profdc9/Emu2350/EmuBoard2350/EmuBoard2350.pdf

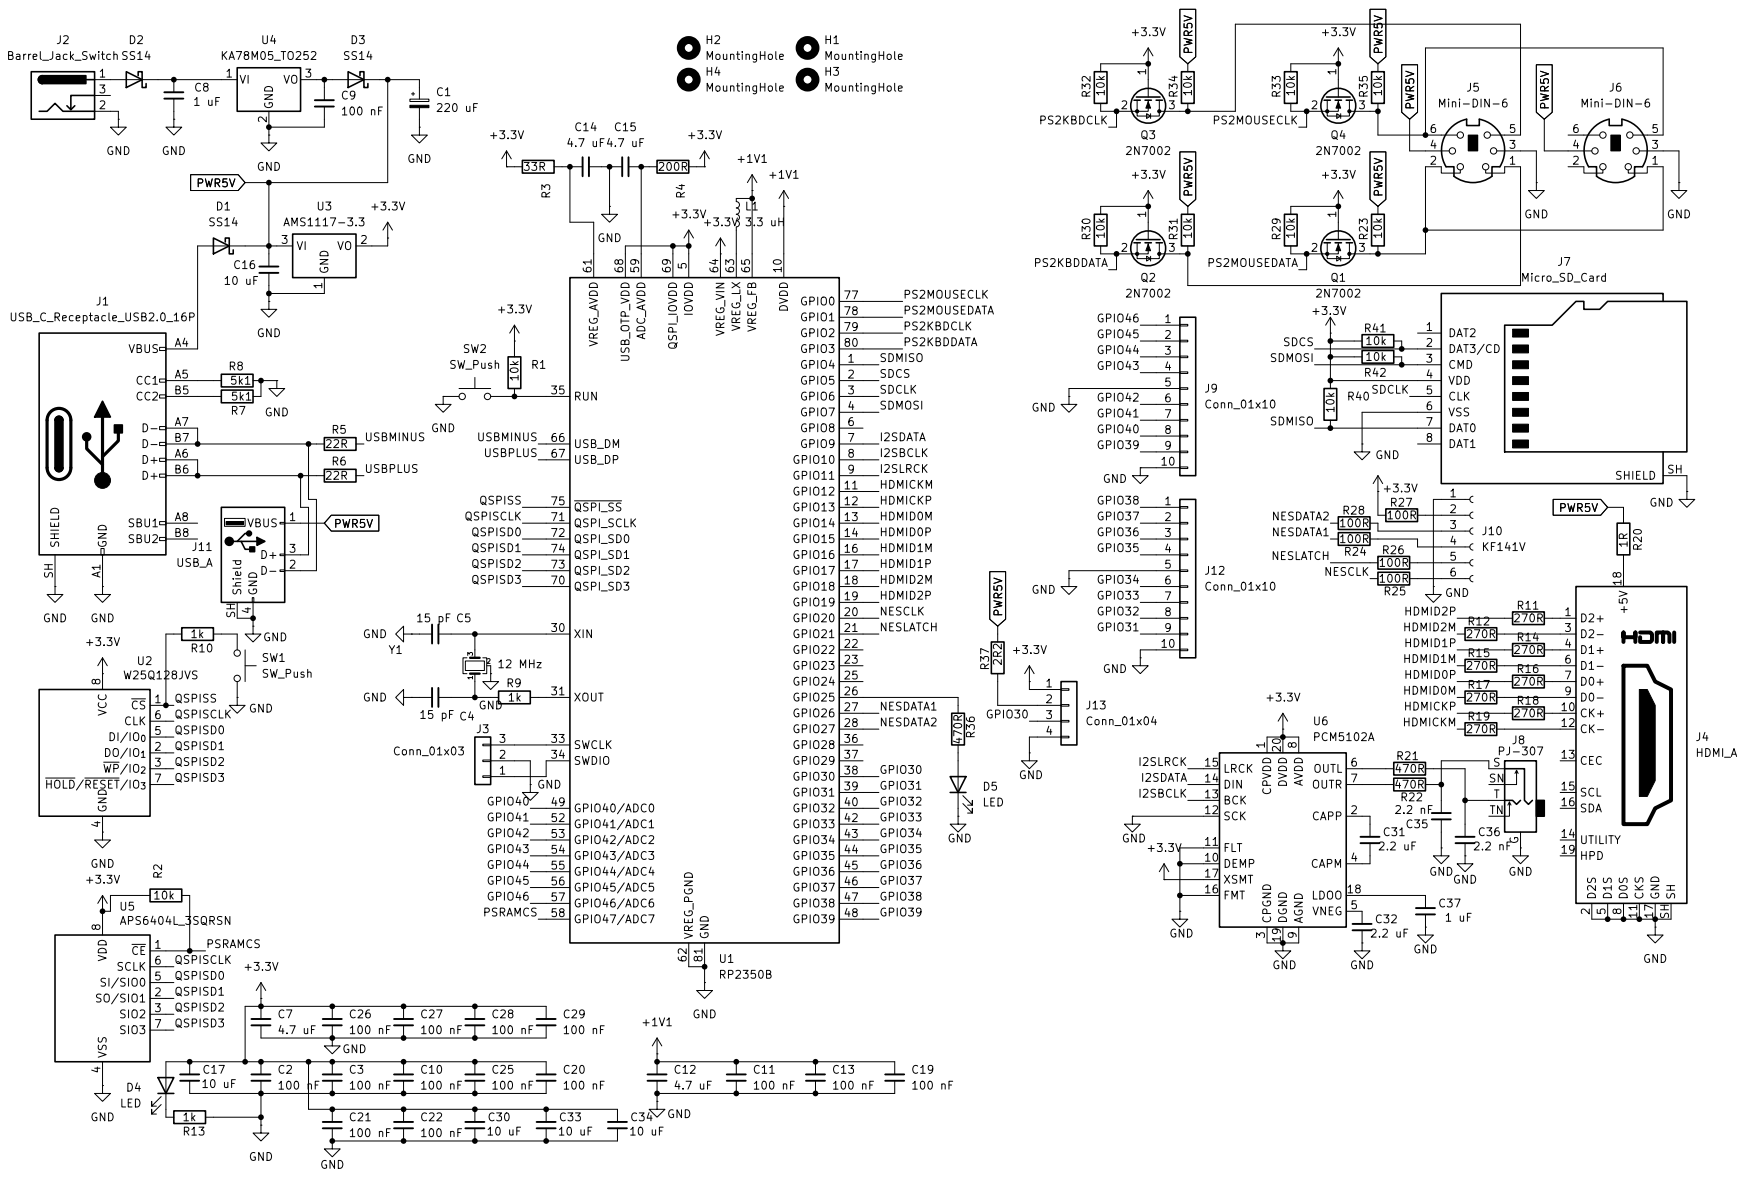
[picture p2: page 1]
