profdc9/Emu2350/EmuBoard2350/EmuBoard2350.kicad_pcb

## KiCad design EmuBoard2350/EmuBoard2350.kicad_pcb (2026-10-18)

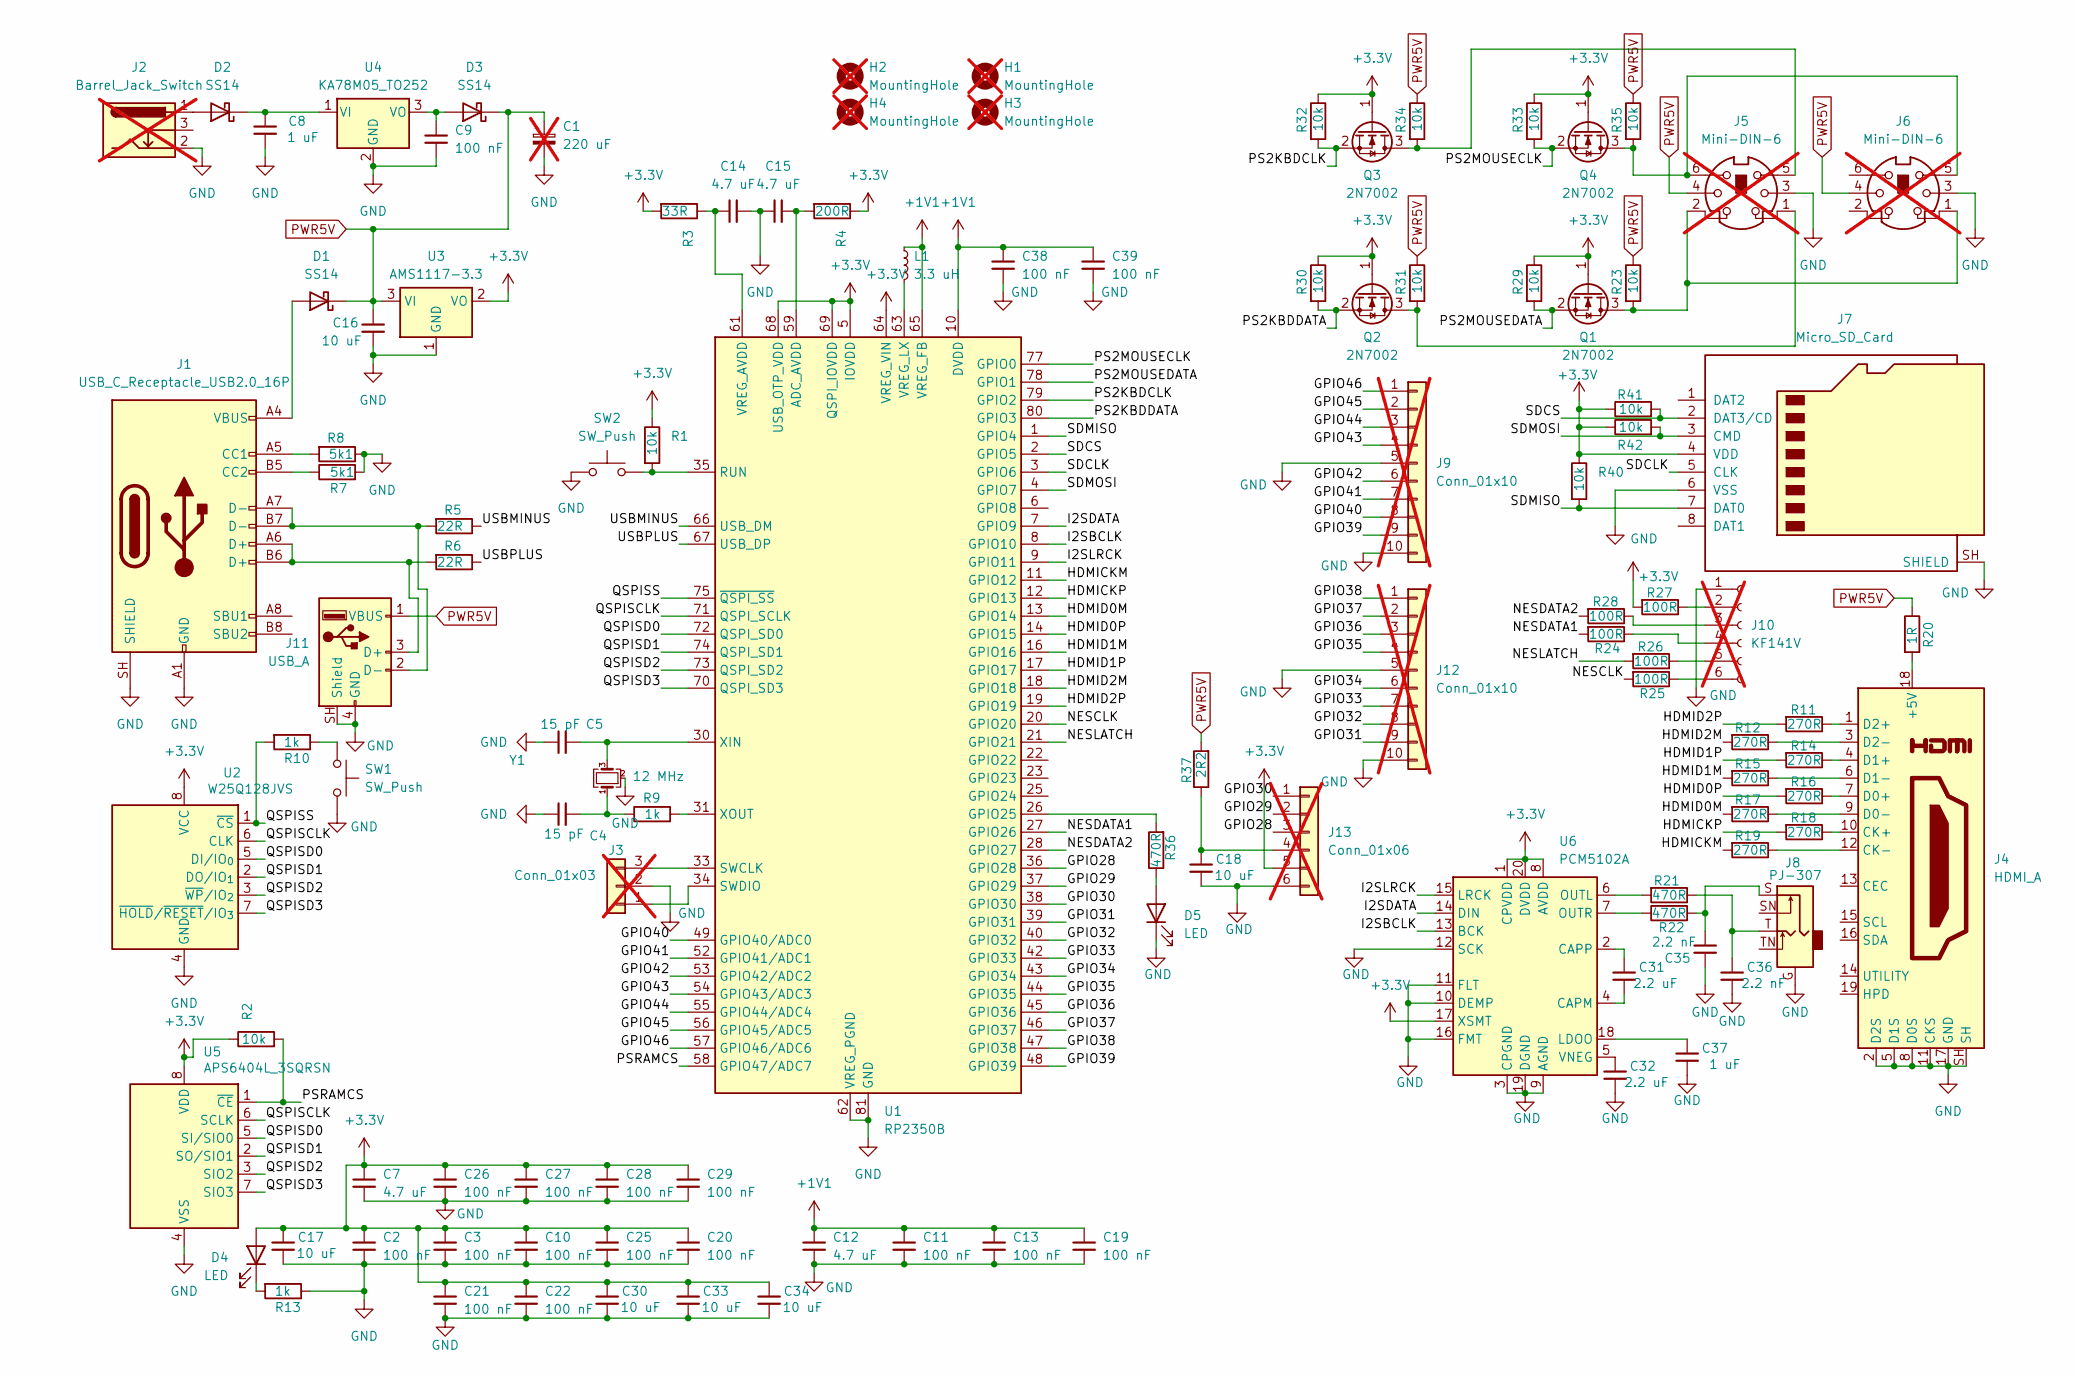
[picture p3: schematic EmuBoard2350.kicad_sch]

Parts:
C1: 220 uF; CP_Radial_D5.0mm_P2.00mm; LCSC DNP; not fitted
C2, C3, C9, C10, C11, C13, C19, C20, C21, C22, C25, C26, C27, C28, C29, C38, C39: 100 nF; C_0402_1005Metric; LCSC C1525
C4, C5: 15 pF; C_0402_1005Metric; LCSC C1548
C7, C12, C14, C15: 4.7 uF; C_0603_1608Metric; LCSC C19666
C8, C37: 1 uF; C_0603_1608Metric; LCSC C15849
C16, C17, C18, C30, C33, C34: 10 uF; C_0603_1608Metric; LCSC C19702
C31, C32: 2.2 uF; C_0603_1608Metric; LCSC C23630
C35, C36: 2.2 nF; C_0603_1608Metric; LCSC C1604
D1, D2, D3: SS14; D_SMA; LCSC C2480
D4: LED; LED_0805_2012Metric; LCSC C2297
D5: LED; LED_0805_2012Metric; LCSC C2296
H1, H2, H3, H4: MountingHole; MountingHole_3.2mm_M3; not fitted
J1: USB_C_Receptacle_USB2.0_16P; TYPE-C-31-M-12; LCSC C165948
J2: Barrel_Jack_Switch; BarrelJack_Horizontal; not fitted
J3: Conn_01x03; PinHeader_1x03_P2.54mm_Vertical; not fitted
J4: HDMI_A; HDMI_A_Molex_208658-1001_Horizontal; LCSC C111617
J5, J6: Mini-DIN-6; Connector_Mini-DIN_Female_6Pin_2rows; not fitted
J7: Micro_SD_Card; GCT-MEM2055-00-190-01-A; LCSC C91145
J8: PJ-307; LCSC C16684
J9, J12: Conn_01x10; KF141-terminal-block-10pos; not fitted
J10: KF141V; KF141-terminal-block-6pos; not fitted
J11: USB_A; USB_A_Connfly_DS1095; LCSC C2344
J13: Conn_01x06; KF141-terminal-block-6pos; not fitted
L1: 3.3 uH; L_1008_2520Metric; LCSC C5832359
Q1, Q2, Q3, Q4: 2N7002; SOT-23; LCSC C8545
R1, R2, R23, R29, R30, R31, R32, R33, R34, R35, R40, R41, R42: 10k; R_0402_1005Metric; LCSC C25744
R3: 33R; R_0402_1005Metric; LCSC C25105
R4: 200R; R_0402_1005Metric; LCSC C25087
R5, R6: 22R; R_0402_1005Metric; LCSC C25092
R7, R8: 5k1; R_0402_1005Metric; LCSC C25905
R9, R10, R13: 1k; R_0402_1005Metric; LCSC C11702
R11, R12, R14, R15, R16, R17, R18, R19: 270R; R_0603_1608Metric; LCSC C22966
R20: 1R; R_0805_2012Metric; LCSC C25271
R21, R22, R36: 470R; R_0805_2012Metric; LCSC C17710
R24, R25, R26, R27, R28: 100R; R_0603_1608Metric; LCSC C22775
R37: 2R2; R_0805_2012Metric; LCSC C17521
SW1, SW2: SW_Push; TS-1088-AR02016; LCSC C720477
U1: RP2350B; QFN-80-1EP_10x10mm_P0.4mm_EP3.4x3.4mm
U2: W25Q128JVS; SOIC-8_5.3x5.3mm_P1.27mm; LCSC C97521
U3: AMS1117-3.3; SOT-223-3_TabPin2; LCSC C6186
U4: KA78M05_TO252; TO-252-2; LCSC C58069
U5: APS6404L_3SQRSN; SOIC-8_3.9x4.9mm_P1.27mm; LCSC C5333729
U6: PCM5102A; TSSOP-20_4.4x6.5mm_P0.65mm; LCSC C107671
Y1: 12 MHz; Crystal_SMD_3225-4Pin_3.2x2.5mm; LCSC C20625731

Connections:
+1V1: C11.1, C12.1, C13.1, C19.1, C38.1, C39.1, L1.1, U1.10 (DVDD), U1.32 (DVDD), U1.51 (DVDD), U1.65 (VREG_FB)
+3.3V: C2.1, C3.1, C7.1, C10.1, C17.1, C20.1, C21.1, C22.1, C25.1, C26.1, C27.1, C28.1, C29.1, C30.1, C33.1, C34.1, D4.2 (A), J7.4 (VDD), J13.5, Q1.1 (G), Q2.1 (G), Q3.1 (G), Q4.1 (G), R1.1, R2.1, R3.2, R4.1, R27.2, R29.1, R30.1, R32.1, R33.1, R40.1, R41.1, R42.1, U1.5 (IOVDD), U1.15 (IOVDD), U1.24 (IOVDD), U1.29 (IOVDD), U1.41 (IOVDD), U1.50 (IOVDD), U1.60 (IOVDD), U1.64 (VREG_VIN), U1.68 (USB_OTP_VDD), U1.69 (QSPI_IOVDD), U1.76 (IOVDD), U2.8 (VCC), U3.2 (VO), U5.8 (VDD), U6.1 (CPVDD), U6.8 (AVDD), U6.17 (XSMT), U6.20 (DVDD)
/GPIO28: J13.3, U1.36 (GPIO28)
/GPIO29: J13.2, U1.37 (GPIO29)
/GPIO30: J13.1, U1.38 (GPIO30)
/GPIO31: J12.9, U1.39 (GPIO31)
/GPIO32: J12.8, U1.40 (GPIO32)
/GPIO33: J12.7, U1.42 (GPIO33)
/GPIO34: J12.6, U1.43 (GPIO34)
/GPIO35: J12.4, U1.44 (GPIO35)
/GPIO36: J12.3, U1.45 (GPIO36)
/GPIO37: J12.2, U1.46 (GPIO37)
/GPIO38: J12.1, U1.47 (GPIO38)
/GPIO39: J9.9, U1.48 (GPIO39)
/GPIO40: J9.8, U1.49 (GPIO40/ADC0)
/GPIO41: J9.7, U1.52 (GPIO41/ADC1)
/GPIO42: J9.6, U1.53 (GPIO42/ADC2)
/GPIO43: J9.4, U1.54 (GPIO43/ADC3)
/GPIO44: J9.3, U1.55 (GPIO44/ADC4)
/GPIO45: J9.2, U1.56 (GPIO45/ADC5)
/GPIO46: J9.1, U1.57 (GPIO46/ADC6)
/HDMICKM: R19.2, U1.11 (GPIO12)
/HDMICKP: R18.2, U1.12 (GPIO13)
/HDMID0M: R17.2, U1.13 (GPIO14)
/HDMID0P: R16.2, U1.14 (GPIO15)
/HDMID1M: R15.2, U1.16 (GPIO16)
/HDMID1P: R14.2, U1.17 (GPIO17)
/HDMID2M: R12.2, U1.18 (GPIO18)
/HDMID2P: R11.2, U1.19 (GPIO19)
/I2SBCLK: U1.8 (GPIO10), U6.13 (BCK)
/I2SDATA: U1.7 (GPIO9), U6.14 (DIN)
/I2SLRCK: U1.9 (GPIO11), U6.15 (LRCK)
/NESCLK: R25.2, U1.20 (GPIO20)
/NESDATA1: R24.2, U1.27 (GPIO26)
/NESDATA2: R28.2, U1.28 (GPIO27)
/NESLATCH: R26.2, U1.21 (GPIO21)
/PS2KBDCLK: Q3.2 (S), R32.2, U1.79 (GPIO2)
/PS2KBDDATA: Q2.2 (S), R30.2, U1.80 (GPIO3)
/PS2MOUSECLK: Q4.2 (S), R33.2, U1.77 (GPIO0)
/PS2MOUSEDATA: Q1.2 (S), R29.2, U1.78 (GPIO1)
/PSRAMCS: R2.2, U1.58 (GPIO47/ADC7), U5.1 (~CE)
/QSPISCLK: U1.71 (QSPI_SCLK), U2.6 (CLK), U5.6 (SCLK)
/QSPISD0: U1.72 (QSPI_SD0), U2.5 (DI/IO_{0}), U5.5 (SI/SIO0)
/QSPISD1: U1.74 (QSPI_SD1), U2.2 (DO/IO_{1}), U5.2 (SO/SIO1)
/QSPISD2: U1.73 (QSPI_SD2), U2.3 (~WP/IO_{2}), U5.3 (SIO2)
/QSPISD3: U1.70 (QSPI_SD3), U2.7 (~HOLD/~RESET/IO_{3}), U5.7 (SIO3)
/QSPISS: R10.2, U1.75 (~QSPI_SS), U2.1 (~CS)
/SDCLK: J7.5 (CLK), U1.3 (GPIO6)
/SDCS: J7.2 (DAT3/CD), R41.2, U1.2 (GPIO5)
/SDMISO: J7.7 (DAT0), R40.2, U1.1 (GPIO4)
/SDMOSI: J7.3 (CMD), R42.2, U1.4 (GPIO7)
/USBMINUS: R5.1, U1.66 (USB_DM)
/USBPLUS: R6.1, U1.67 (USB_DP)
GND: C1.2, C2.2, C3.2, C4.2, C5.2, C7.2, C8.2, C9.2, C10.2, C11.2, C12.2, C13.2, C14.2, C15.1, C16.2, C17.2, C18.2, C19.2, C20.2, C21.2, C22.2, C25.2, C26.2, C27.2, C28.2, C29.2, C30.2, C32.2, C33.2, C34.2, C35.1, C36.2, C37.2, C38.2, C39.2, D5.1 (K), J1.A1 (GND), J1.A12 (GND), J1.B1 (GND), J1.B12 (GND), J1.SH (SHIELD), J2.2, J3.2, J4.2 (D2S), J4.5 (D1S), J4.8 (D0S), J4.11 (CKS), J4.17 (GND), J4.SH, J5.3, J6.3, J7.6 (VSS), J7.SH (SHIELD), J8.G, J9.5, J9.10, J10.1, J11.4 (GND), J11.SH (Shield), J12.5, J12.10, J13.6, R7.2, R8.1, R13.1, SW1.2, SW2.1, U1.62 (VREG_PGND), U1.81 (GND), U2.4 (GND), U3.1 (GND), U4.2 (GND), U5.4 (VSS), U6.3 (CPGND), U6.9 (AGND), U6.10 (DEMP), U6.11 (FLT), U6.12 (SCK), U6.16 (FMT), U6.19 (DGND), Y1.2 (G), Y1.4 (G)
unnamed: C4.1, R9.1, Y1.1
unnamed: C35.2, J8.S, R22.2
unnamed: C36.1, J8.T, R21.1
unnamed: D1.2 (A), J1.A4 (VBUS), J1.A9 (VBUS), J1.B4 (VBUS), J1.B9 (VBUS)
unnamed: D2.2 (A), J2.1
unnamed: C8.1, D2.1 (K), U4.1 (VI)
unnamed: C9.1, D3.2 (A), U4.3 (VO)
unnamed: D4.1 (K), R13.2
unnamed: D5.2 (A), R36.1
unnamed: J1.A5 (CC1), R8.2
unnamed: J1.B5 (CC2), R7.1
unnamed: J3.1, U1.34 (SWDIO)
unnamed: J3.3, U1.33 (SWCLK)
unnamed: J4.18 (+5V), R20.2
unnamed: J4.10 (CK+), R18.1
unnamed: J4.12 (CK-), R19.1
unnamed: J4.7 (D0+), R16.1
unnamed: J4.9 (D0-), R17.1
unnamed: J4.4 (D1+), R14.1
unnamed: J4.6 (D1-), R15.1
unnamed: J4.1 (D2+), R11.1
unnamed: J4.3 (D2-), R12.1
unnamed: J10.2, R27.1
unnamed: J10.3, R28.1
unnamed: J10.4, R24.1
unnamed: J10.5, R26.1
unnamed: J10.6, R25.1
unnamed: J1.A6 (D+), J1.B6 (D+), J11.3 (D+), R6.2
unnamed: J1.A7 (D-), J1.B7 (D-), J11.2 (D-), R5.2
unnamed: C18.1, J13.4, R37.1
unnamed: J5.2, J6.1, Q1.3 (D), R23.2
unnamed: J5.1, Q2.3 (D), R31.2
unnamed: J5.5, Q3.3 (D), R34.2
unnamed: J5.6, J6.5, Q4.3 (D), R35.2
unnamed: R10.1, SW1.1
unnamed: C15.2, R4.2, U1.59 (ADC_AVDD)
unnamed: R36.2, U1.26 (GPIO25)
unnamed: R1.2, SW2.2, U1.35 (RUN)
unnamed: C14.1, R3.1, U1.61 (VREG_AVDD)
unnamed: L1.2, U1.63 (VREG_LX)
unnamed: C5.1, U1.30 (XIN), Y1.3
unnamed: R9.2, U1.31 (XOUT)
unnamed: C31.2, U6.4 (CAPM)
unnamed: C31.1, U6.2 (CAPP)
unnamed: C37.1, U6.18 (LDOO)
unnamed: R21.2, U6.6 (OUTL)
unnamed: R22.1, U6.7 (OUTR)
unnamed: C32.1, U6.5 (VNEG)
PWR5V: C1.1, C16.1, D1.1 (K), D3.1 (K), J5.4, J6.4, J11.1 (VBUS), R20.1, R23.1, R31.1, R34.1, R35.1, R37.2, U3.3 (VI)

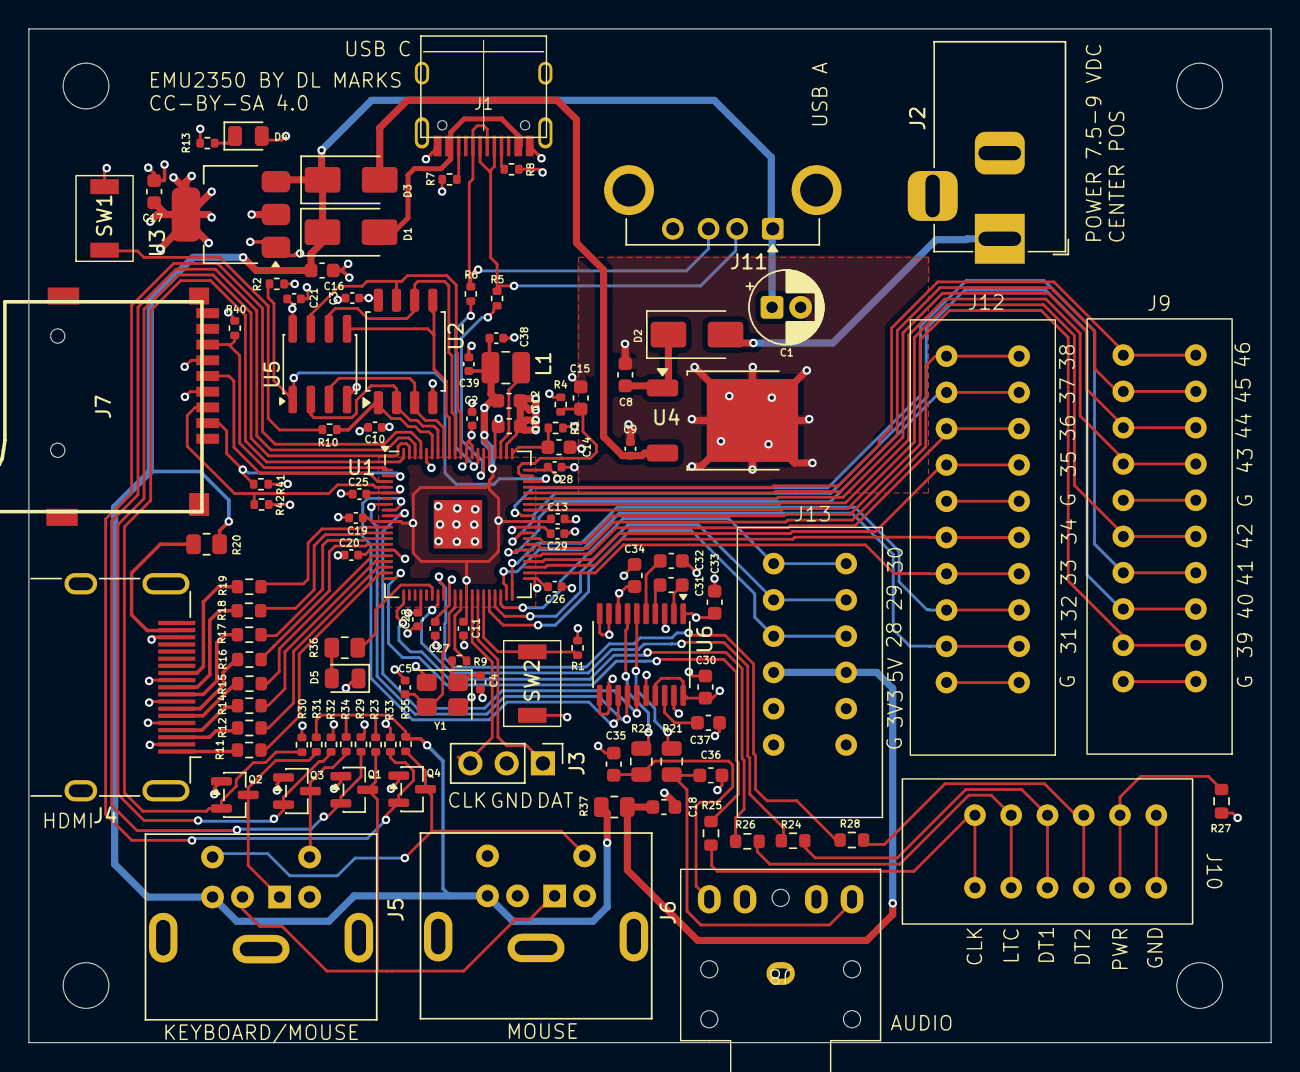
[picture p4: board EmuBoard2350.kicad_pcb from above]

Board: 4 copper layers, 87.0 x 71.0 mm, 112 parts (0 on the bottom side), 103 nets.
