profdc9/Emu2350/(notices)

Notices in the files:
EmuBoard2350/EmuBoard2350.kicad_pcb:
CC-BY-SA 4.0
